km8donth8/RISCV32-ChampionChip/ControlUnit_FSM.jpeg

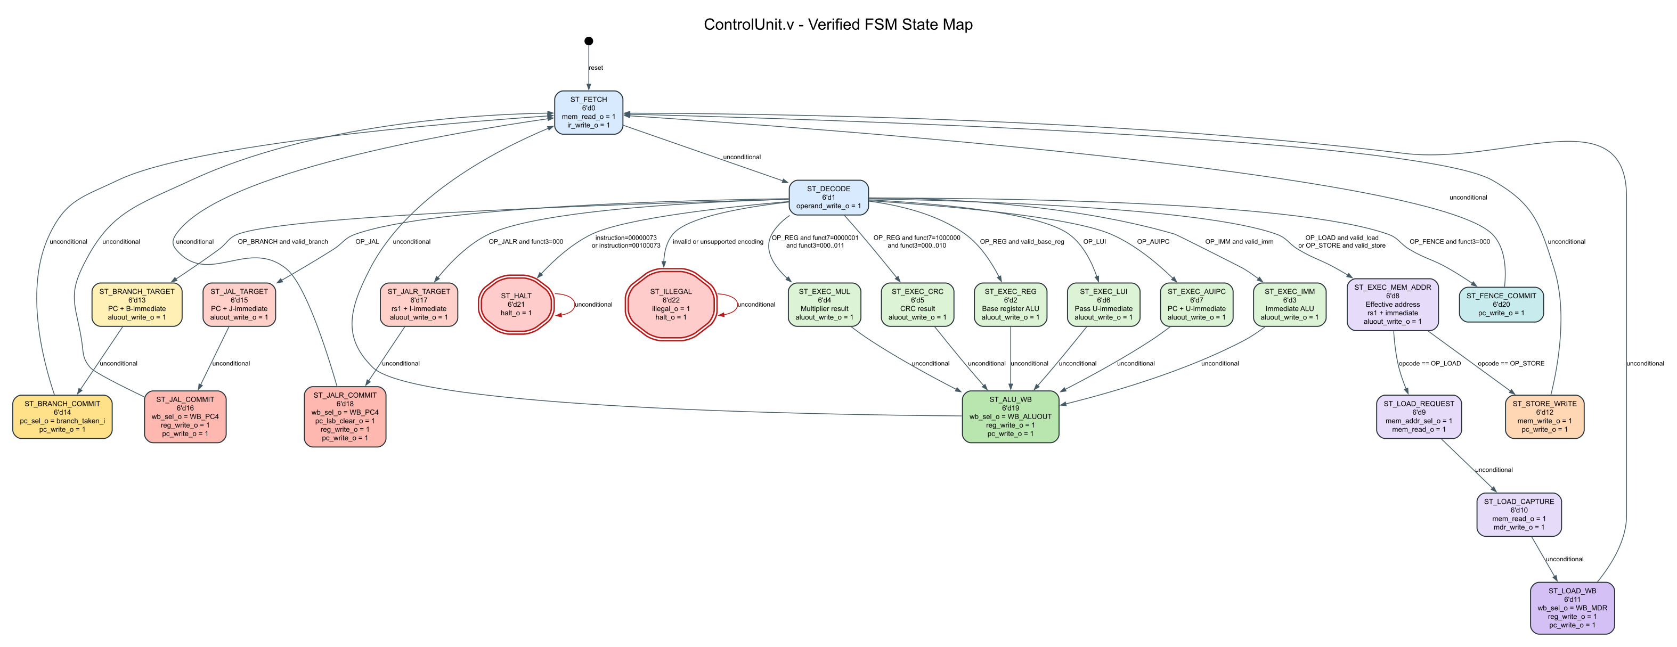
ControlUnit_FSM.jpeg
