km8donth8/RISCV32-ChampionChip/datapath.png

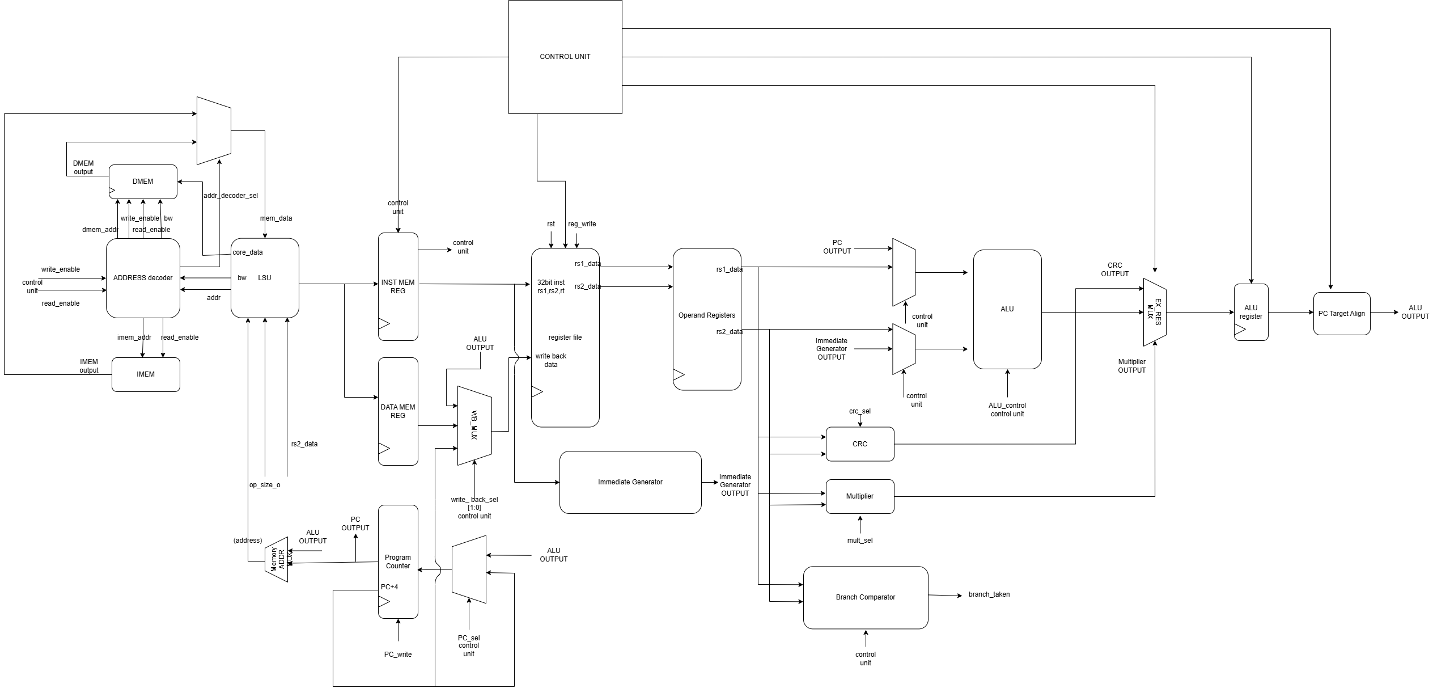
datapath.png
