km8donth8/RISCV32-ChampionChip/pic/B_register.png

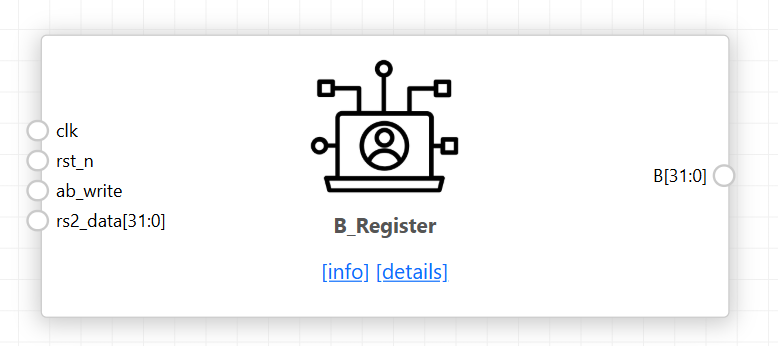
pic/B_register.png
