km8donth8/RISCV32-ChampionChip/pic/firmware_log.png

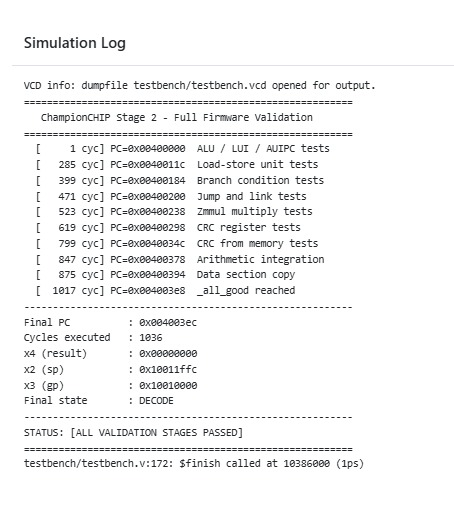
pic/firmware_log.png
